mvyskoc/avrlirc/circuit/avrlirc.odt

avrlirc
LIRC IR receiver based on ATTiny 25

Bottom side (mirrored on the right)

Bottom side – multi PCB
