mvyskoc/avrlirc/circuit/avrlirc-01-sch.png

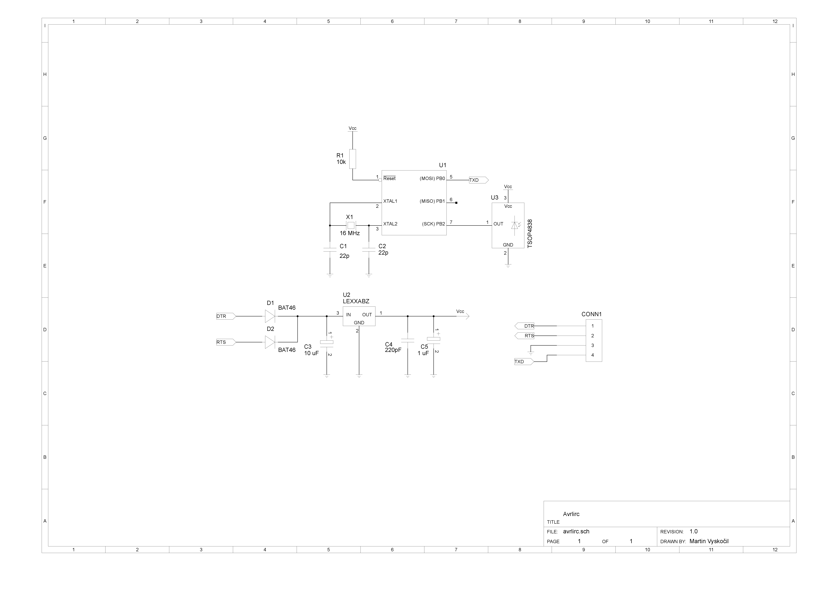
circuit/avrlirc-01-sch.png
