mvyskoc/avrlirc/circuit/avrlirc-bottom-mirrored.png

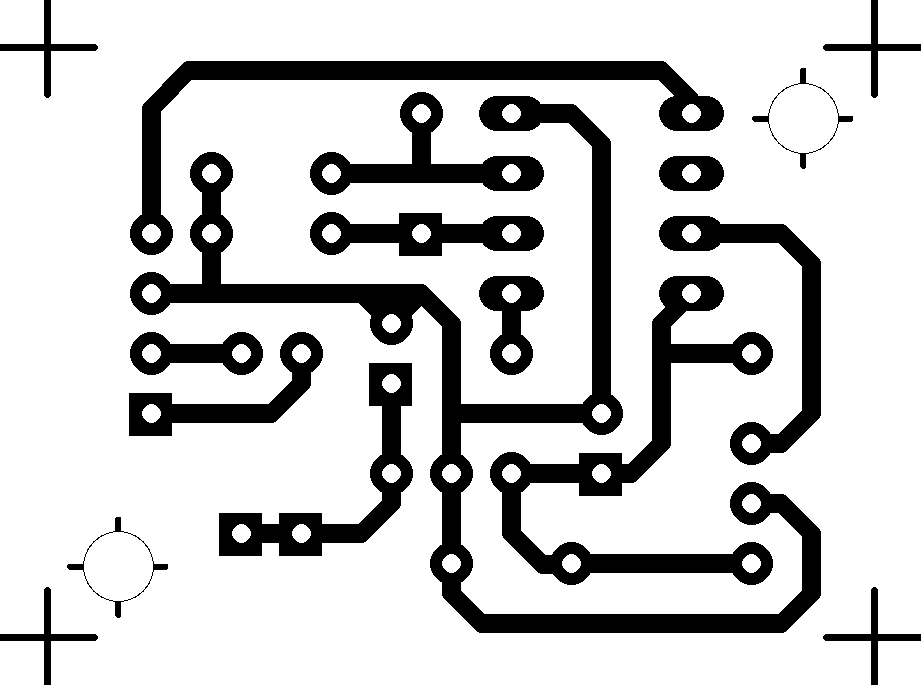
circuit/avrlirc-bottom-mirrored.png
