mvyskoc/avrlirc/circuit/avrlirc-bottom.png

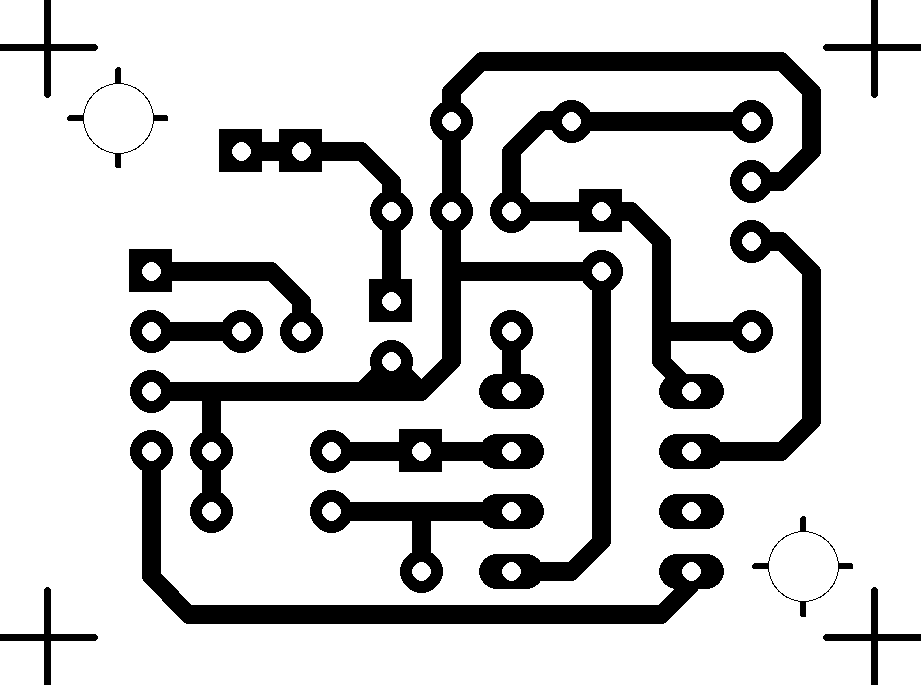
circuit/avrlirc-bottom.png
