mvyskoc/avrlirc/circuit/mpcb-bottom.png

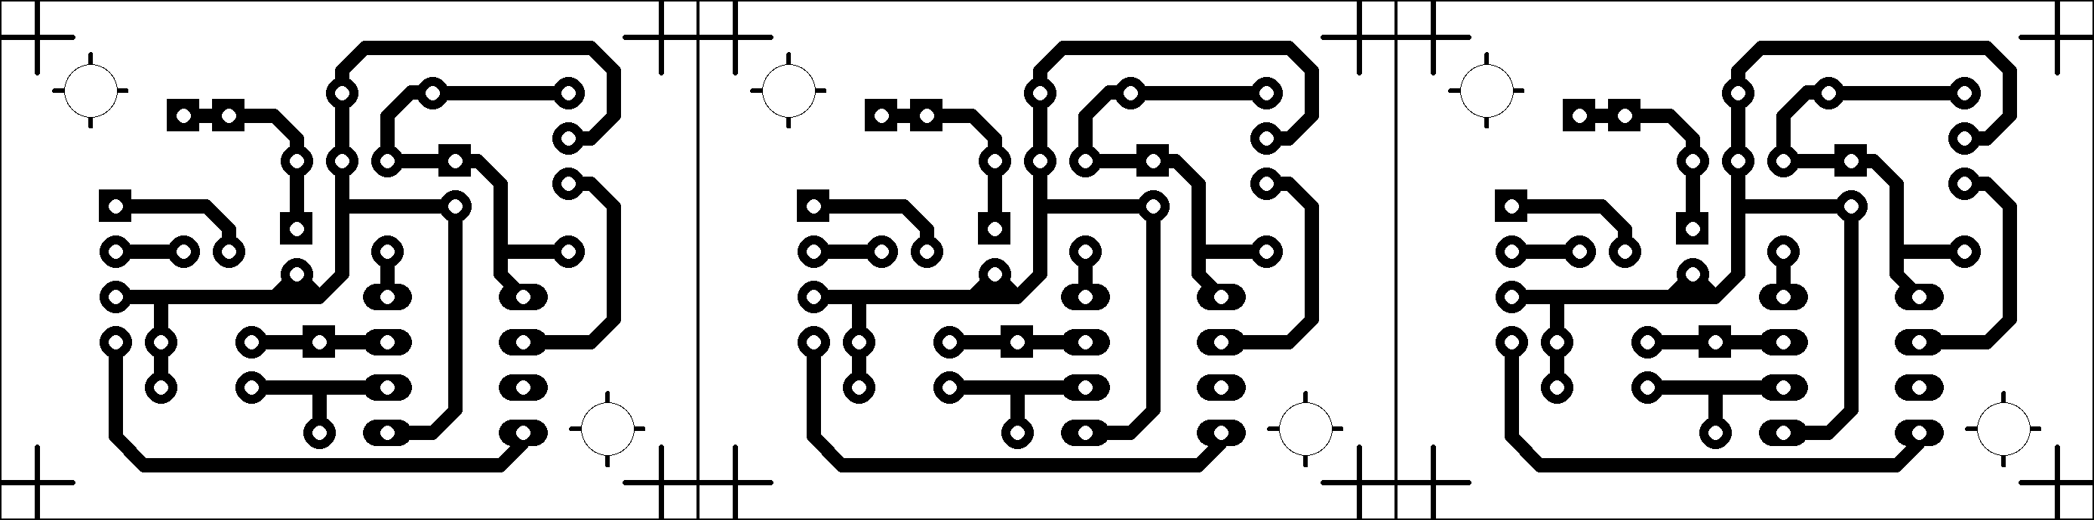
circuit/mpcb-bottom.png
