mvyskoc/avrlirc/circuit/avrlirc-sch.pdf

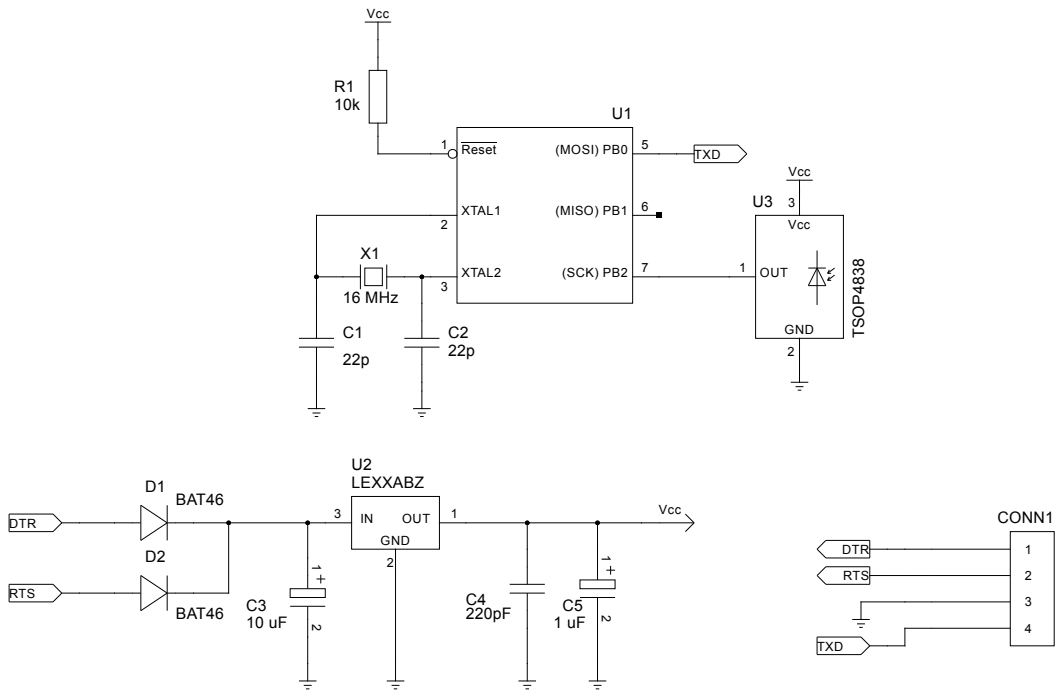
[picture p5: page 1]

FILE: | | REVISION:
PAGE | OF | DRAWN BY:

## TITLE
