mvyskoc/avrlirc/(list of files, drawings)

Other design files:
circuit/avrlirc.pcb
