mvyskoc/avrlirc/circuit/avrlirc-top-assembly.png

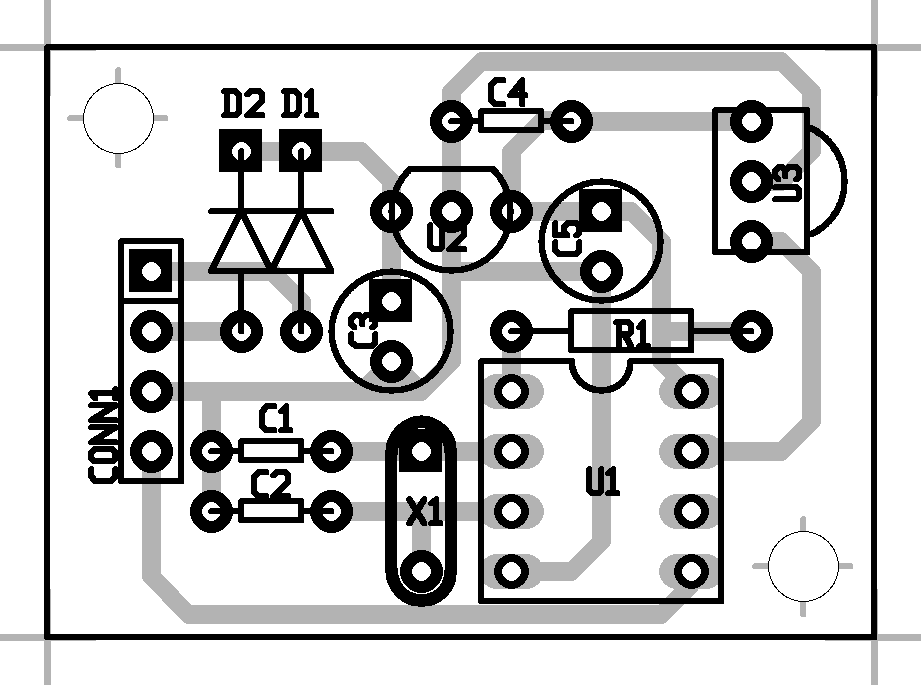
circuit/avrlirc-top-assembly.png
